PAVAN-NIKHIL-993/SIH_2026_022/SMART-DEHUMIDIFIER/production/05-WARRANTY-CARD.md

# Warranty card (template)

**Smart Dehumidifier Pillar** · Serial ________ · Date of sale ________

Covered 12 months from date of sale: controller electronics, fans, coil,
workmanship. Battery covered 6 months (manufacturing defects only — capacity
fade from misuse/over-discharge excluded).

Not covered: water ingress through open door/bay, use without the 50 A
fuse, coil modified from 0.30–0.36 Ω, chamber run above 95 °C setpoint,
connectors other than solar panel / battery / AC bypass as documented.

Service: describe the symptom + serial; the fault text on the website and
the `[stat]` serial line travel with the unit — quote them.
