PAVAN-NIKHIL-993/SIH_2026_022/SMART-DEHUMIDIFIER/media/README.md

# Media — photos & concept art

- `pillar-concept.png` — AI concept render of the 6 ft pillar (marketing
  placeholder until you photograph the real unit).

## Shot list for the real product (add as `photo-*.jpg`)
1. Full pillar in sun, panel beside it — the hero shot
2. Open door: trays + coil glow (2 s exposure)
3. Phone in hand showing the dashboard (fire tab, gold graph)
4. Battery bay + controller bay with covers off
5. Close-up: serial label + QC sheet on the unit
6. 15 s video: Start → MAX badge → fans ramp → DONE beeps (if buzzer fitted)

Screenshots for docs: dashboard (fire theme), parameters page, graph with
2+ series, forecast strip, OTA page mid-upload.
