PAVAN-NIKHIL-993/SIH_2026_022/SMART-DEHUMIDIFIER/docs/manual/README.md

# Smart Dehumidifier — Full Manual (optional deep-dive docs)

Start here. These files document **everything from scratch**: parts, wiring,
code, flashing, deployment on solar, every known disadvantage (solved or
not), every error you can hit, and where this project can go.

| # | File | What's inside |
|---|---|---|
| 01 | [PARTS-AND-TOOLS.md](01-PARTS-AND-TOOLS.md) | Full bill of materials with approx. prices, tools, consumables |
| 02 | [BUILD-STEP-BY-STEP.md](02-BUILD-STEP-BY-STEP.md) | Assembly from zero: chassis, every wire of every module, first boot |
| 03 | [SOFTWARE-ARCHITECTURE.md](03-SOFTWARE-ARCHITECTURE.md) | Every source file explained, state machine, PID, settings & API reference |
| 04 | [DEPLOYMENT-AND-COMMISSIONING.md](04-DEPLOYMENT-AND-COMMISSIONING.md) | Safe bench test, first real run, solar sizing math, going live, online mode setup |
| 05 | [ERRORS-AND-FIXES.md](05-ERRORS-AND-FIXES.md) | Symptom → cause → fix: compile, upload, runtime, website, control behavior |
| 06 | [LIMITATIONS-SOLVED-AND-UNSOLVED.md](06-LIMITATIONS-SOLVED-AND-UNSOLVED.md) | Every disadvantage of this design, honestly rated: solved / mitigated / open |
| 07 | [WHATS-LEFT-AND-THE-REACH.md](07-WHATS-LEFT-AND-THE-REACH.md) | What is deliberately not built yet, and how far this system can scale |

Quick docs: main [README](../../README.md) · [wiring diagram](../wiring-diagram.svg) ·
[advanced ideas vault](../../ADVANCED-IDEAS.txt)
