PAVAN-NIKHIL-993/SIH_2026_022/(commit log)

2026-09-25 Smart DeHummidifier v2.0.21 — complete project (full rename + DS1302 RTC + docs + tooling)
    [01-BOM-FULL.csv, PIN-CONFIG.txt]
2026-09-25 Smart Dehumidifier v2.0.21 post-merge fixes: single-m spelling, RTC bitRead/Write rename, preprocessor cleanup, regenerate sketches
    [PIN-CONFIG.txt]
2026-09-25 Rename project folder smart-dryer -> smart-dehumidifier (SMART-DEHUMIDIFIER product) and update all path references
    [01-BOM-FULL.csv, PIN-CONFIG.txt]
2026-09-25 Rename project folder to SMART-DEHUMIDIFIER (caps) and update all path references
    - Top-level folder smart-dehumidifier -> SMART-DEHUMIDIFIER via git mv
    - Inner Arduino sketches: SMART-DEHUMIDIFIER-single-file / SMART-DEHUMIDIFIER-s3-single-file and .ino files renamed
    - Content references updated (30 files): CONTRIBUTING, README, workflows (ci.yml cd SMART-DEHUMIDIFIER, pages.yml path), docs, platformio, assemble.js outDir/outFile, check-all.sh verify_strings args, etc.
    - Regenerated sketches (380.9KB/372.8KB) and docs/index.html via assemble.js + sync-online.js
    - Sync host RTC test helper rtc-under-test.cpp to rtcBitWrite rename (12 lines)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
    [01-BOM-FULL.csv, PIN-CONFIG.txt]
2026-09-25 Restore v2.0.21 firmware sources corrupted by the patch reconstruction
    The "complete project" import (d0a6972) rebuilt the tree from the
    01a0ccad v2.0.21 patchset, but 23 of its files are *modifications*
    against a base that was never in this repo. Their hunks were applied
    onto v2.0.19 text instead, which interleaved old and new code. Some
    files were repaired in 87e86b5; 14 were still broken, so the firmware
    could not compile:
    src/control.h struct LogRec missing; Settings/FaultRec/Dryer
    fragments interleaved and duplicated
    src/main.cpp boot lost loadSettings(), sensors.begin(),
    battery.begin() and dryer.begin(cfg)
    src/web.cpp ~440 duplicated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
    [01-BOM-FULL.csv, PIN-CONFIG.txt]
2026-09-25 CI: real arduino-cli compile of every sketch + full gate + Node 24 actions
    Nothing in CI ever ran a C++ compiler, which is how a firmware that
    could not build (control.h without struct LogRec) stayed green.
    - scripts/compile-sketches.sh (new): pinned arduino-cli build of all
    15 sketches with the documented IDE board settings.
    esp32 group: classic + S3 firmware, board-test-s3, 10 sensor tests
    (esp32:esp32@3.3.12; S3 = CDCOnBoot, 16 MB, PSRAM off)
    avr group: display-bridge-uno + display-test-uno
    (arduino:avr@1.8.8, Adafruit GFX 1.12.6, MCUFRIEND_kbv 3.0.0)
    Runs locally too; CI caches ~/.arduino15.
    - .github/problem-matchers/gcc.json: compiler er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
    [Arduino.h]
2026-09-25 Fix three bench sketches that never compiled; one CI annotation per failed sketch
    The first real compile (esp32:esp32@3.3.12, S3 settings) failed these,
    which no check had ever built:
    - board-test-s3: EspClass::getEfuseMac() takes no argument and returns
    a uint64_t. Unpack the 6 bytes (first octet = low byte), which also
    fixes the scrambled byte order the MAC line printed (0,5,3,4,2,1).
    - battery-test: a row label is built with String concatenation, so
    jRows() now takes const String& (StringSumHelper -> const char* error).
    - dht-test: dhtFrame() comes before struct DhtDev, and the IDE inserts
    its auto-generated prototypes above the first function, so
    cardDht(DhtDev&) had no type y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
    [battery-test.ino, board-test-s3.ino, dht-test.ino]
2026-09-25 Point ONLINE_UI_URL at this repo's Pages site; fix the Pages setup steps
    ONLINE_UI_URL still pointed at https://pavan-nikhil-993.github.io/arena/,
    a repo with no Pages site, so http://192.168.4.1/online could never load
    the hosted UI. pages.yml in *this* repo publishes to
    https://pavan-nikhil-993.github.io/SIH_2026_022/, so both config.h and
    config-s3.h use that now.
    The comments and SMART-DEHUMIDIFIER/README.md said to deploy Pages "from
    a branch, main /docs". That cannot work here: the site lives in
    SMART-DEHUMIDIFIER/docs, and branch deploys only serve the repo root or
    a top-level /docs. They now say Source: GitHub Actions, like manual 04,
    which now also names the default URL. online-tes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
    [config-s3.h, config.h]
2026-09-25 Fix the classic-ESP32 firmware link error and the rtc-test macro clash
    Found by the new real compile (esp32:esp32@3.3.12):
    - Classic firmware failed to link: undefined reference to
    rtc::statusText() and rtc::writeNow(). The classic build has
    RTC_ENABLED 0, which compiles out all of rtc.cpp, but the serial
    console's `rtc` / `rtcset` commands call it unguarded. rtc.h already
    documents the contract "all calls are no-ops ... (classic variant)",
    so rtc.cpp now provides that no-op API in an #else branch. Callers
    need no #if, and the commands report "no DS1302 on this build"
    instead of breaking the build. The stub branch was built on host g++
    with -Wall -Wextra -Werror; the enabled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
    [rtc-test.ino, rtc.cpp]
2026-09-25 CI compile: cache survives failing builds, clean logs, fix the MCUFRIEND pin
    - actions/cache only saves on job success, so while a sketch was broken
    every run re-downloaded the ~1 GB ESP32 toolchain. Split into
    cache/restore -> compile-sketches.sh --setup-only -> cache/save ->
    compile. The key is derived from just the pinned-version lines in the
    script, so unrelated edits reuse the cache.
    - arduino-cli --no-color: no ANSI escapes in logs and annotations.
    - MCUFRIEND_kbv: the library index lists the v3.0.0 tag as
    "3.0.0-Release" (its library.properties version), so pin that.
    The AVR setup also now runs `lib update-index`, which
    `core update-index` does not do.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
2026-09-25 ui-test: jsdom ^24 -> ^30.1.1 (current major)
    All 100 checks (ui-test 81, online-test 19) pass unchanged on jsdom 30.1.1.
    jsdom 30 needs Node ^22.22.2 or ^24.15; CI runs Node 24 (setup-node v7).
2026-09-25 CI compile: also build the S3 firmware in FreeRTOS mode (DRYER_RTOS=1)
    main.cpp has a second build mode (config.h: DRYER_RTOS, #ifndef-guarded)
    that nothing compiled. compile-sketches.sh now builds it with
    --build-property compiler.cpp.extra_flags=-DDRYER_RTOS=1. That property
    is empty in the esp32 core's platform.txt; build.extra_flags must not be
    overridden because it carries the S3 USB settings. That is 16 builds in
    all; build() takes an optional property and labels it "(DRYER_RTOS=1)".
2026-09-25 Docs: fix stale pins, ArduinoJson leftovers, repo name and a broken anchor
    - README.md: contents link #4-feature-list-firmware-v18 -> -v20 (the
    heading is "Feature list (firmware v2.0)"). The repository map now
    lists the DS1302 RTC sensor test, compile-sketches.sh, the symbol
    audit and the host RTC test.
    - SMART-DEHUMIDIFIER/README.md pin table: the S3 outdoor DHT11 is on 41
    (not 35, abandoned in v2.0.13; 33->41 in v2.0.20). The S3 door switch
    is on 21 (not 34; v2.0.20).
    "Arduino IDE: open src/main.cpp, install ArduinoJson" was wrong twice:
    the IDE needs the generated single-file sketch, and the firmware has
    used no libraries for many releases (manual 05 says so).
    - Manual 02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
2026-09-25 Remove the four Arena patch dumps from the repo root (15 MB, kept in history)
    01a06264-….patch v2.0.19 session export (full snapshot)
    01a0ccad-….patch v2.0.21 session export (diff vs an older base)
    1patch.txt / 2patch.txt CRLF duplicates of the two above
    They were uploaded as recovery material for rebuilding the project.
    That rebuild is now exact and hash-verified (see "Restore v2.0.21
    firmware sources ..."), so the dumps are no longer needed, and their
    stale smart-dryer/arena paths kept showing up in repo-wide searches.
    They stay in history. To get one back:
    git checkout a95f96f -- 01a0ccad-b132-73a2-a923-732e2f03a31b.patch
    git checkout 079dd6f -- 1patch.txt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
2026-09-25 v2.0.22: FW_VERSION + CHANGELOG (sources restored, every sketch compiled)
    FW_VERSION 2.0.21 -> 2.0.22 in src/config.h and
    variants/esp32-s3/config-s3.h, sketches regenerated. The CHANGELOG entry
    covers the exact source restoration, the new real compile in CI (16
    builds) and the five compile bugs it found, ONLINE_UI_URL, the CI/Pages
    workflow updates, the doc fixes and repo hygiene.
    [config-s3.h, config.h]
2026-09-25 Website: royal blue + golden brown theme (no black), refined layout
    The dashboard, kiosk and loader pages sat on a near-black background
    (#070b14 / #0b1026 / #101512). New look, same markup and JS hooks:
    - Backdrop: a royal-blue sky over a golden-brown horizon with a warm
    gold seam. A plain blue->brown blend goes muddy grey in the middle;
    that was tried and rejected. It is a fixed body::before layer, so it
    also works on iPhones, where background-attachment:fixed is ignored.
    - Glass royal cards with a gold top edge and gold titles. Header and
    sticky tabs on glass: golden-brown "Dashboard", royal-blue
    "Parameters".
    - Every button styled. Tare, Calibrate, Reset, Save, the mode preset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
    [webui.h]
2026-09-25 RTC: DS1307 on the I2C bus replaces the DS1302 (the owner's module)
    The owner's clock module is a DS1307, an I2C part. The firmware drove a
    3-wire DS1302 on S3 pins 40/42/47, so the fitted module was never found.
    - src/rtc.*: library-free Wire driver at 0x68, same rtc:: API, so callers
    are unchanged. ACK detection, one burst read (a consistent snapshot),
    CH (clock halt) = untrusted until set, BCD sanity, 12/24 h decoding
    (the DS1307 uses bit6), writes in 24 h mode with CH cleared. The 56-byte
    RAM and the control register are never touched. DS3231 boards work
    unchanged (the century bit is masked).
    - Wiring: the shared I2C0 bus, S3 SDA 8 / SCL 9 (classic 21/22), which
    the bus alre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
    [01-BOM-FULL.csv, PIN-CONFIG.txt]
2026-09-25 Sensor-test pages: fix the invalid JSON that broke every page; new host test
    Every bench sketch's phone page polls /data and sat on "loading..." forever:
    - jRows() builds rows as ["k","v"],["k","v"] with no enclosing brackets,
    and every card embedded them as "rows":<rows>. That is invalid JSON as
    soon as a card has two or more rows.
    - Single-card pages (battery, door, scale, keypad, the last eeprom/supply
    card) also never closed the card object.
    - keypad-test additionally never closed the cards array or the root
    object, and wrote its key grid as "1,""2,""3," (commas inside quotes).
    All fixed.
    New tools/sensor-page-test compiles every arduino-ide/sensor-tests/*.ino
    on the host agai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
    [Arduino.h, WebServer.h, WiFi.h, aht10-test.ino, battery-test.ino]
2026-09-25 v2.0.23: FW_VERSION + CHANGELOG (DS1307 RTC, royal & gold UI, bench-page fixes)
    FW_VERSION 2.0.22 -> 2.0.23 in both configs, sketches regenerated. The
    CHANGELOG entry covers:
    - the DS1307 I2C driver: wiring, 5 V supply, pull-ups; GPIO 40/42/47
    freed; the 20:00-23:59 decoding and early-[diag] fixes;
    - the EEPROM size probe;
    - the royal-blue / golden-brown website and its per-phone migration off
    the saved black background;
    - the invalid-JSON fix on every sensor-test page, plus its host test;
    - the preview server, pin parking, the BOM repair and the doc updates.
    [config-s3.h, config.h]
2026-09-26 Single-file sketches: correct S3 flashing steps, no phantom TFT pins, stable build date
    - S3 copy's HOW TO FLASH said to pick the classic "ESP32 Dev Module";
    it now gives the variants-README / CI settings (ESP32S3 Dev Module,
    USB CDC On Boot: Enabled, Flash Size 16MB, PSRAM Disabled, native USB
    port). The classic copy keeps its steps.
    - Pin quick-reference hides the TFT placeholder pins while
    DISPLAY_ENABLED is 0 (the S3 table listed GPIO 41 and 48 twice) and
    adds a NOTE saying the /display web page replaces the screen.
    - assemble.js keeps an existing copy byte-for-byte when only its
    "build YYYY-MM-DD" line would change. check-all step 6 (CI on every
    push) regenerates and needs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
2026-09-26 Add s3_T1: the owner's named copy of the S3 single-file firmware
    - arduino-ide/s3_T1/s3_T1.ino = byte-identical copy of
    SMART-DEHUMIDIFIER-s3-single-file.ino (v2.0.23), in a folder of the
    same name as the Arduino IDE requires.
    - compile-sketches.sh builds it with the S3 FQBN (guarded: skipped once
    the folder is deleted) and posts a one-line "N builds OK / N failed"
    notice on the CI run page.
    - READMEs: 16 sketches, the copy is listed in the layout tree and the
    flash steps. CHANGELOG entry under v2.0.23.
2026-11-06 Add esp32_T1: minimal ESP32 Dev + 2x DHT22 + BTS7960 (via 555) firmware
    arduino-ide/esp32_T1/esp32_T1.ino - one file, no libraries, nothing but
    the heater and two DHT22: hotspot AgarbattiDryer + one royal-blue /
    golden-brown page (live readings, target 40-80 C + time 1-1440 min,
    Start / Update / Stop; settings kept in NVS, a cycle never auto-resumes).
    Heater wiring as the full build (GPIO25 -> 555 pin 4 -> RPWM 1 kHz,
    GPIO26 -> R_EN+L_EN, LPWM to GND); DHT22 on GPIO32 / GPIO33.
    Control: full power to target-1.5 C, then PID with Kp 10 / Kd 5 as the
    full firmware and Ki 0.05 (0.2 oscillated 4-9 C with DHT22-only sensing
    in 9 of 72 simulated plants). Safety: heater off at boot / idle / fault,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
2026-11-06 esp32_T1 v1.1: fan on one EN pin + cleaner page; undo the extra edits
    esp32_T1.ino (still one file, ESP32 Dev Module, no libraries):
    - fan on a single EN pin, GPIO 14 (same pin as the full build's L298N
    ENB; IN3 -> 5V, IN4 -> GND). Auto = vents while drying when humidity
    >= 60 %, off at <= 50 %; On / Off buttons on the page override it.
    Off at boot, on Stop and on any fault (in Auto).
    - cleaner page: two cards - temperature, target + humidity, heater /
    fan / time-left tiles, one sensor line; target + minutes, Start
    (Update) / Stop, fan Auto / On / Off.
    Only the requested .ino files stay added: the README, CHANGELOG,
    check-all.sh, compile-sketches.sh and preview-server edits from t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
2026-11-06 esp32_T1 v1.2: Dehumidifier - 70 % heater limit, history, graphs, RTC, buzzer, fan runs, presets
    Single file, ESP32 Dev Module (only this .ino changes):
    - name: "Dehumidifier" on the page and as the WiFi name (password unchanged)
    - heater PWM hard-limited to 70 % (custom "heater max" 10-70 %)
    - one sensor box: average on top, DHT22 #1 and #2 below; Live / History /
    Settings tabs
    - batch history: last 10 batches (start time, minutes, target, max temp,
    humidity start -> end, energy, result), kept in flash
    - live graphs of temperature (with target) and humidity for the batch
    - clock on the ESP32 internal RTC: set by date/time or "use phone time",
    taken from the phone automatically when un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
2026-11-07 esp32_T1: fix "'Note' does not name a type" in the Arduino IDE
    The IDE inserts automatic prototypes for every function right before the
    first function; struct Note was declared after that point, so the
    prototypes of play() / playAlways() could not see it. All types now sit
    above the first function (comment added). No behaviour change.
2026-11-07 TEMPORARY: CI compiles only esp32_T1 with the real ESP32 core (reverted in the next commit)
2026-11-07 Revert the temporary CI change (esp32_T1 compiled OK with the real ESP32 core 3.3.12)
2026-11-07 esp32_T1 v1.3: fan switches on at 60 % within one reading, runs >= 10 s
    Auto (while drying): humidity >= 60 % turns the fan on at the next DHT22
    reading (2.5 s); it runs at least 10 s and stops once the humidity is
    below 58 % - no more fixed 3-minute runs. Parameter 'Fan min run' is in
    seconds (5-600, default 10); new flash keys so an old 70 %/3 min setting
    is not reused. Readings shown on the page are the DHT22 values as read.
2026-11-07 Revert the temporary CI change (esp32_T1 v1.3 compiled OK with the real ESP32 core 3.3.12)
